EricNakamura/easy-artnet-interface/hardware/cad/easy artnet interface cad 2.FCStd

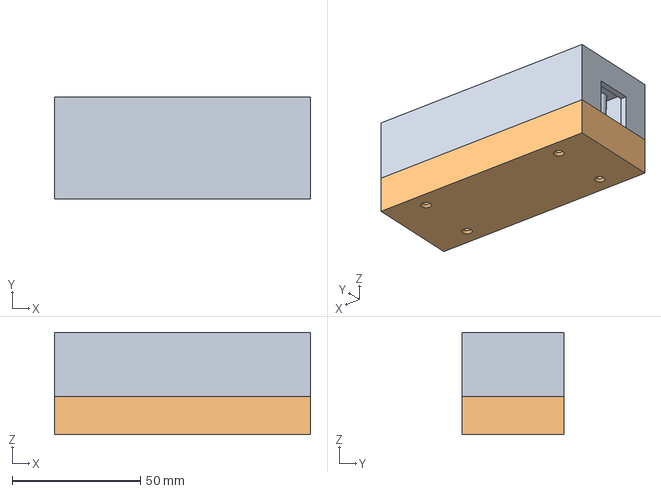
[picture p1: CAD file, 2026-11-01]
hardware/cad/easy artnet interface cad 2.FCStd
100.0 x 40.0 x 40.0 mm
Corpo001
Corpo002
