EricNakamura/easy-artnet-interface/hardware/cad/easy artnet interface cad.FCStd

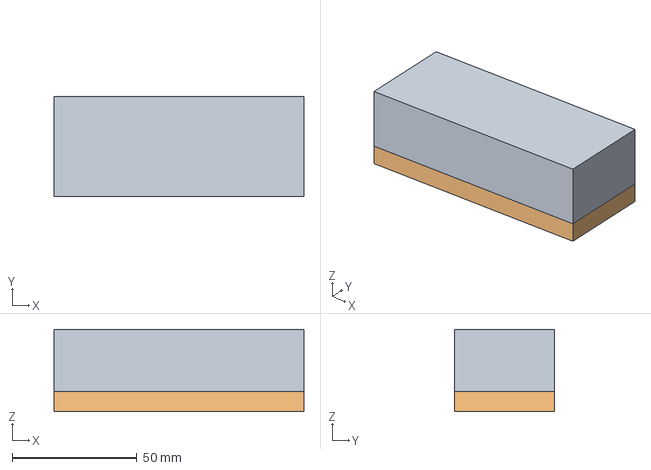
[picture p2: CAD file, 2026-11-01]
hardware/cad/easy artnet interface cad.FCStd
100.0 x 40.0 x 33.0 mm
Corpo001
Corpo002
