EricNakamura/easy-artnet-interface/hardware/kicad/easy-artnet-interface.kicad_pcb

## KiCad design hardware/kicad/easy-artnet-interface.kicad_pcb (2026-11-01)

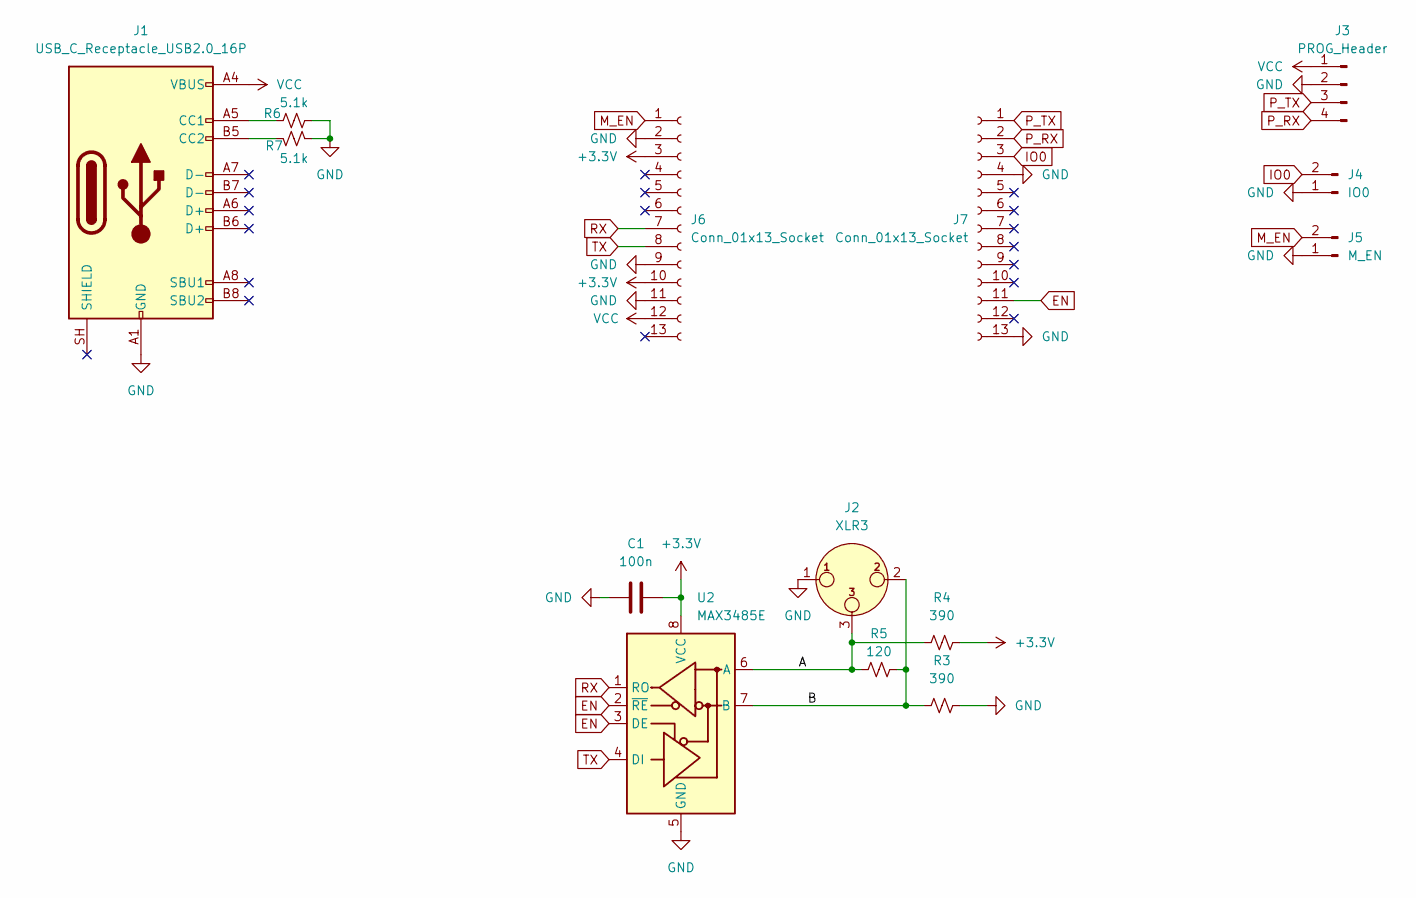
[picture p3: schematic easy-artnet-interface.kicad_sch]

Parts:
C1: 100n; C_0805_2012Metric_Pad1.18x1.45mm_HandSolder
J1: USB_C_Receptacle_USB2.0_16P; USB_C_Receptacle_G-Switch_GT-USB-7010ASV
J2: XLR3; PinHeader_1x03_P2.54mm_Vertical
J3: PROG_Header; PinHeader_1x04_P2.54mm_Vertical
J4: IO0; PinHeader_1x02_P2.54mm_Vertical
J5: M_EN; PinHeader_1x02_P2.54mm_Vertical
J6, J7: Conn_01x13_Socket; PinHeader_1x13_P2.54mm_Vertical
R3, R4: 390; R_0805_2012Metric_Pad1.20x1.40mm_HandSolder
R5: 120; R_0805_2012Metric_Pad1.20x1.40mm_HandSolder
R6, R7: 5.1k; R_0805_2012Metric_Pad1.20x1.40mm_HandSolder
U2: MAX3485E; SOP-8_3.76x4.96mm_P1.27mm

Connections:
+3.3V: C1.2, J6.3, J6.10, R4.2, U2.8 (VCC)
/A: J2.3, R4.1, R5.1, U2.6 (A)
/B: J2.2, R3.1, R5.2, U2.7 (B)
EN: J7.11, U2.2 (~RE), U2.3 (DE)
GND: C1.1, J1.A1 (GND), J1.A12 (GND), J1.B1 (GND), J1.B12 (GND), J2.1, J3.2, J4.1, J5.1, J6.2, J6.9, J6.11, J7.4, J7.13, R3.2, R6.2, R7.1, U2.5 (GND)
IO0: J4.2, J7.3
M_EN: J5.2, J6.1
unnamed: J1.A5 (CC1), R6.1
unnamed: J1.B5 (CC2), R7.2
P_RX: J3.4, J7.2
P_TX: J3.3, J7.1
RX: J6.7, U2.1 (RO)
TX: J6.8, U2.4 (DI)
VCC: J1.A4 (VBUS), J1.A9 (VBUS), J1.B4 (VBUS), J1.B9 (VBUS), J3.1, J6.12

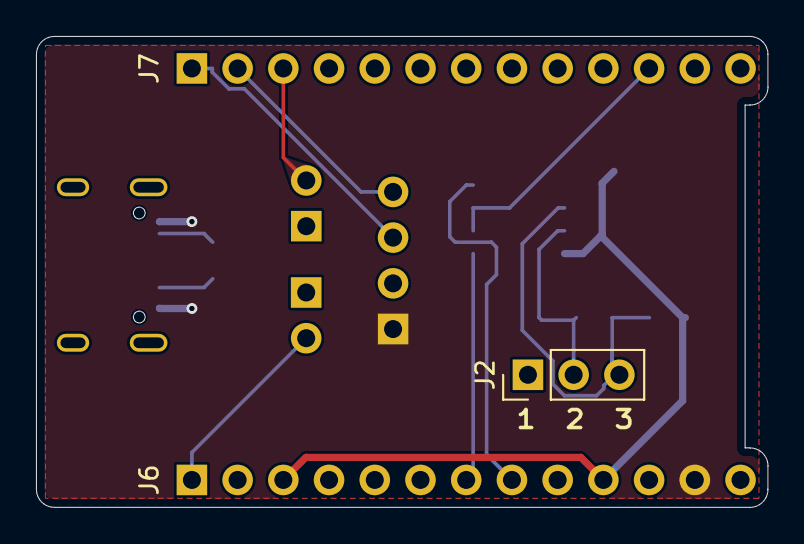
[picture p4: board easy-artnet-interface.kicad_pcb from above]

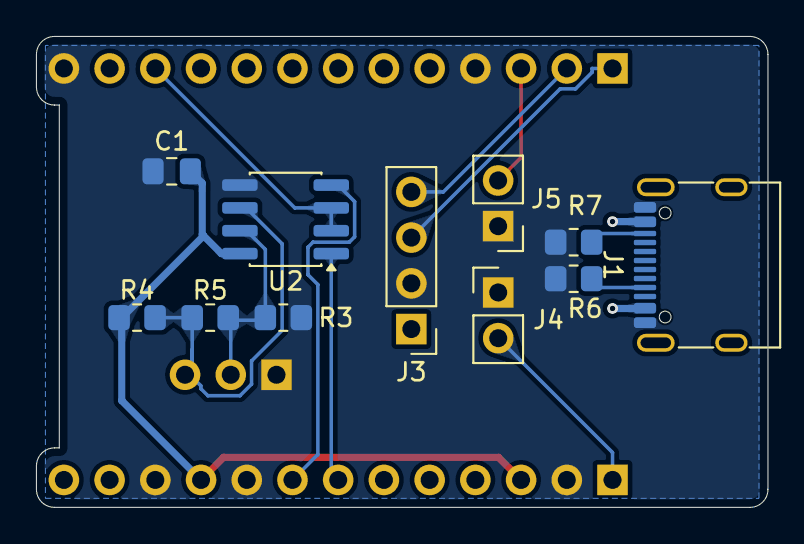
[picture p5: board easy-artnet-interface.kicad_pcb from below]

Board: 2 copper layers, 40.6 x 26.2 mm, 14 parts (11 on the bottom side), 14 nets.
