EricNakamura/easy-artnet-interface/(notices)

Notices in the files:
firmware/esp32_w5500_sem_int/esp32_w5500_sem_int.ino:
This program is free software: you can redistribute it and/or modify
it under the terms of the GNU General Public License as published by
the Free Software Foundation, either version 3 of the License, or
(at your option) any later version.
README.md:
License: GPLv3
